20BBrown14/BoopBox/hardware/boopbox-proto/boopbox-proto.kicad_sch

## KiCad design hardware/boopbox-proto/boopbox-proto.kicad_sch (2026-10-18)

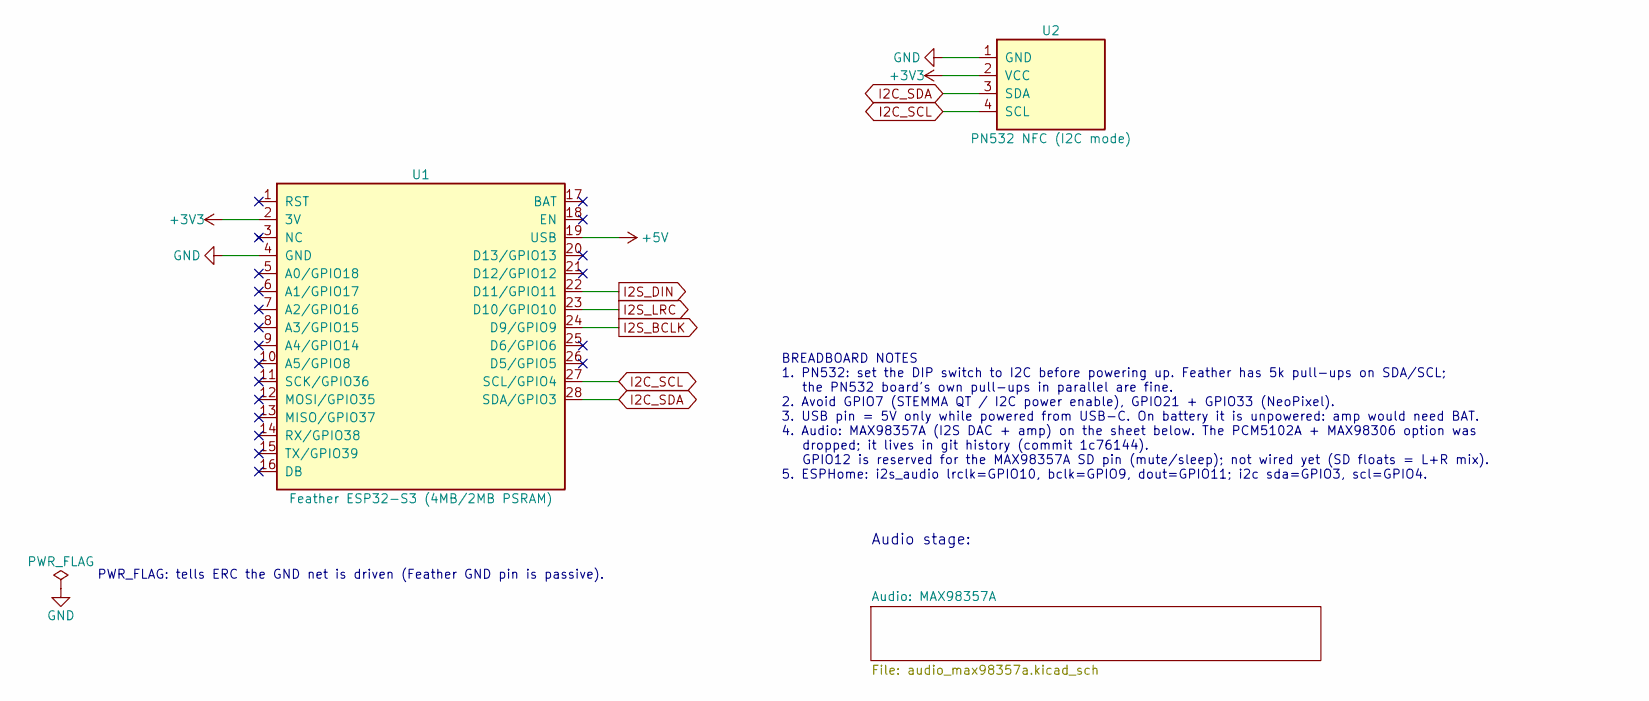
[picture p1: schematic boopbox-proto.kicad_sch]

Parts:
U1: Feather ESP32-S3 (4MB/2MB PSRAM)
U2: PN532 NFC (I2C mode)

Connections:
+3V3: U1.2 (3V), U2.2 (VCC)
+5V: U1.19 (USB)
GND: U1.4 (GND), U2.1 (GND)
I2C_SCL: U1.27 (SCL/GPIO4), U2.4 (SCL)
I2C_SDA: U1.28 (SDA/GPIO3), U2.3 (SDA)
I2S_BCLK: U1.24 (D9/GPIO9)
I2S_DIN: U1.22 (D11/GPIO11)
I2S_LRC: U1.23 (D10/GPIO10)

Notes on the sheet:
PWR_FLAG: tells ERC the GND net is driven (Feather GND pin is passive).
BREADBOARD NOTES 1. PN532: set the DIP switch to I2C before powering up. Feather has 5k pull-ups on SDA/SCL; the PN532 board's own pull-ups in parallel are fine. 2. Avoid GPIO7 (STEMMA QT / I2C power enable), GPIO21 + GPIO33 (NeoPixel). 3. USB pin = 5V only while powered from USB-C. On battery it i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
Audio stage:
