20BBrown14/BoopBox/(commit log)

2026-10-18 Audio max98357a (#2)
    * adding hardware some vib'ed up kicad
    * some ai sloppy kicad just to get started, should probably throw away
    * Settle on MAX98357A audio stage in KiCad schematic
    Drop the PCM5102A + MAX98306 option sheet (kept in history at 1c76144),
    mark GPIO12 reserved for the amp SD pin, update sheet notes and title
    blocks, and ignore KiCad lock/backup files. ERC: 0 violations.
    * Add MAX98357A audio bring-up to firmware and hardware notes
    i2s_audio speaker + speaker media_player (all codecs, volume capped at
    0.7), with a Test Audio URL text entity and Play Test Audio button for
    first-sound testing. Hardware notes now list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
2026-11-08 Add simulated tag read, boop result, and mute switch to firmware
    A "Boop" web group with a Simulate Slug field and a Simulate Tag Read
    button lets the boop flow be tested without a physical tag; it goes
    through the same publish_boop path as a real tap. A Last Boop Result
    sensor shows sent / playing / not-sent. A Mute switch in Audio Test
    reflects and toggles the player's persisted mute state.
2026-11-08 Add Dayton DMA45-4 driver datasheets
2026-11-08 Document the mono amp wiring: GAIN to GND, SD floating
    Matches the breadboard build (notes/breadboard-mono-connections.md):
    12 dB gain and the amp's L+R mix, replacing the GAIN-floating /
    SD-to-VIN left-only description.
2026-11-08 hw notes: cap buttons
2026-11-08 some pin changes before rebasing
2026-11-08 Merge duplicated touch/UI hardware notes
    Combine the two capacitive-button sections into one. Fix the pin plan
    to match the firmware (vol+ GPIO5, vol- GPIO6, play/pause GPIO14).
    Correct how esp32_touch thresholds work on the S3: they are a delta
    over a hardware baseline that freezes while a pad is touched. Add the
    breadboard status, the audio-coupling finding, and the open items.
2026-11-11 Battery POC: fuel gauge sensor, battery rewiring, touch panel tests
    - Firmware (v0.1.0): read the Feather's MAX17048 fuel gauge (I2C 0x36)
    via ESPHome's max17043 driver; show battery % and voltage in the
    web UI Device group.
    - Notes: amp VIN moved USB -> BAT and PN532 VCC -> 3V; full NFC read
    and playback verified on battery alone. Record the battery plan,
    protection (Adafruit 2011 cell has a built-in PCM) and boost
    converter requirements for the LED ring.
    - Notes: touch pad decision (2 cm round pads behind 1 mm PETG) and
    panel tests, including Vol Up on top-panel-v1.
2026-11-11 Draft battery life test plan
2026-11-11 Notes: LED ring on BAT with planned MOSFET switch
    Ring VCC moves from USB 5V to BAT so it works on battery. Update the
    ring wiring table, power budget and pin plan; no level shifter needed
    on BAT. Record the BAT-direct + P-MOSFET high-side switch decision,
    expected losses, and the boost converter as a fallback.
2026-11-14 Add LED ring features (#9)
